javierb07/Fyre/README.md

# Fyre Smartwatch in Development
Smartwatch designed during Summer 2020 at Purdue Milestones
