javierb07/Fyre/Mechanical/Bandless_1.5mm_11.9.stl

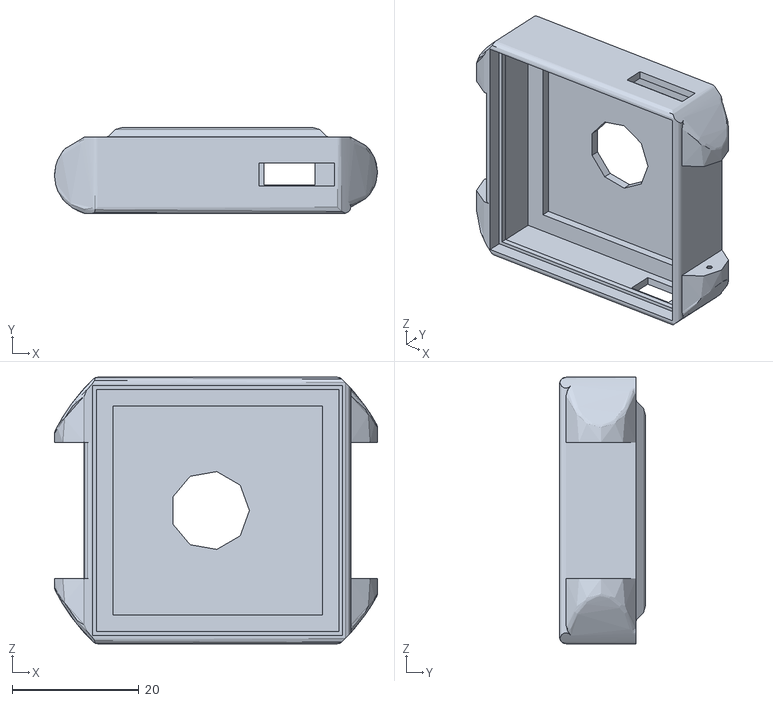
[picture p1: CAD file, 2020-08-12]
Mechanical/Bandless_1.5mm_11.9.stl
50.9 x 13.5 x 42.0
