javierb07/Fyre/Mechanical/Cover_1.5mm_11.9.stl

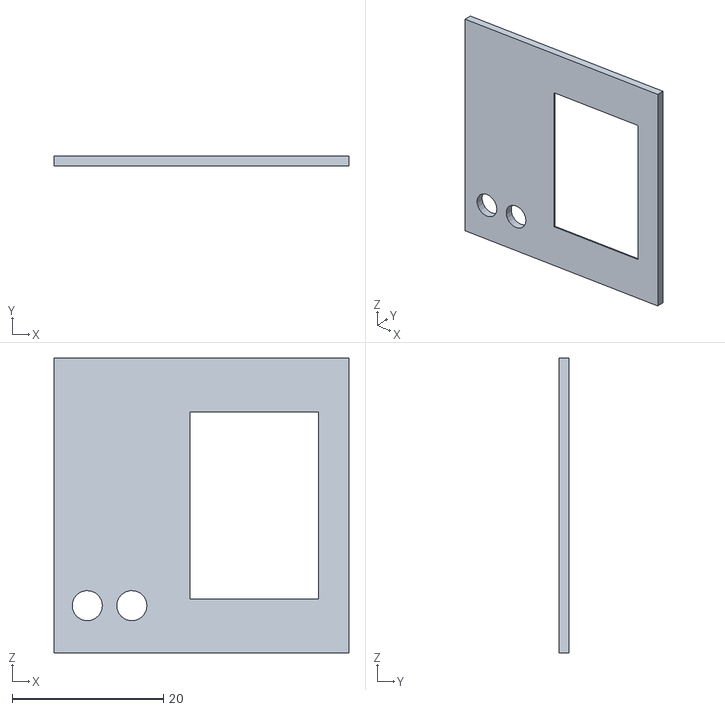
[picture p2: CAD file, 2020-08-12]
Mechanical/Cover_1.5mm_11.9.stl
39.0 x 1.30 x 39.0
