javierb07/Fyre/Hardware/Basic/PPG-Module/Fyre-PPG-Module.brd

## EAGLE design Hardware/Basic/PPG-Module/Fyre-PPG-Module.brd (2020-07-14)

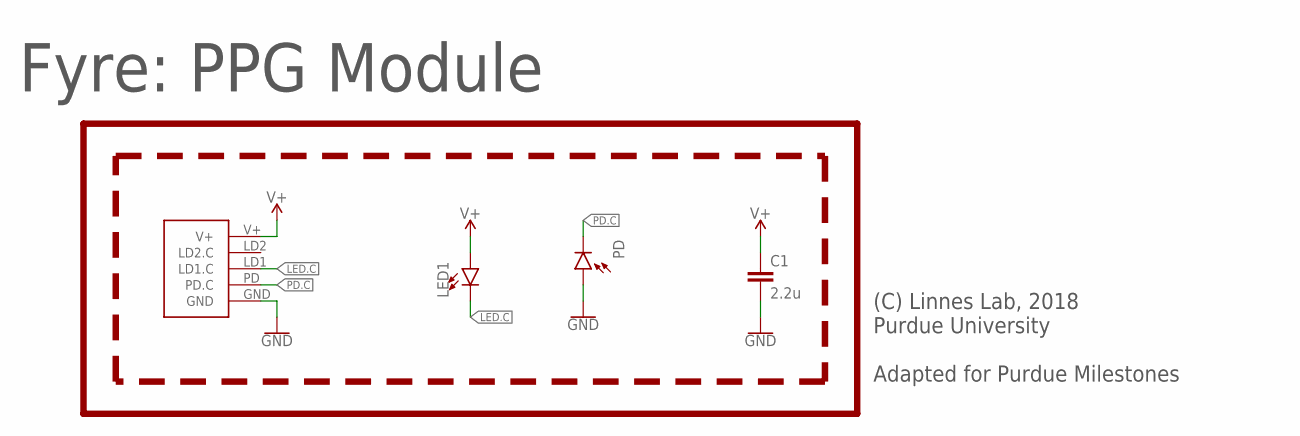
[picture p9: schematic Fyre-PPG-Module.sch]

Parts:
C1: 2.2u; C0603
J1: PPG.MODULE.2
LED1: LED0805; LED-0805
PD: PHOTODIODE.-SMD.GULLWING; 2-SMD.GULLWING
U$3: LINNES.LAB.LOGO

Connections:
GND: C1.2, J1.GND, PD.+ (A)
LED.C: J1.LD1 (LD1.C), LED1.C
PD.C: J1.PD (PD.C), PD.- (C)
V+: C1.1, J1.V+, LED1.A

Notes on the sheet:
Fyre: PPG Module
(C) Linnes Lab, 2018 Purdue University Adapted for Purdue Milestones



Board: 2 copper layers, 12.4 x 12.4 mm, 5 parts (3 on the bottom side), 4 nets.
