javierb07/Fyre/(commit log)

2020-07-01 Created Repo Structure
    [Fyre-BASIC-BOTTOM-BOM.xlsx, Fyre-BASIC-PPG-MODULE-BOM.xlsx, Fyre-BASIC-TOP-BOM.xlsx]
2020-07-01 Removed unnecesary file
    [Fyre-BASIC-TOP-BOM.xlsx]
2020-07-09 Worked on the top board
    [Fyre-BASIC-TOP.brd, Fyre-BASIC-TOP.sch]
2020-07-14 Added bottom and PPG boards
    [Fyre-BASIC-BOTtom.brd, Fyre-BASIC-BOTtom.sch, Fyre-BASIC-PPG-MODULE-BOM.xlsx, Fyre-PPG-Module-BOM.xlsx, Fyre-PPG-Module.brd, Fyre-PPG-Module.sch]
2020-07-19 Completed the top board
    [Fyre-BASIC-BOTtom.brd, Fyre-BASIC-BOTtom.sch, Fyre-BASIC-TOP.brd, Fyre-BASIC-TOP.sch]
2020-07-21 Small changes
    [Fyre-BASIC-TOP.brd, Fyre-BASIC-TOP.sch]
2020-07-29 Included PPG as an Arduino library
2020-08-12 Worked on firmware
    [Bandless_1.5mm_11.9.stl, Cover_1.5mm_11.9.stl, Fyre-BASIC-BOTTOM-BOM.xlsx]
